MonstaWyatt/networking_project/images/breadboard_esp32_pirsensor.jpg

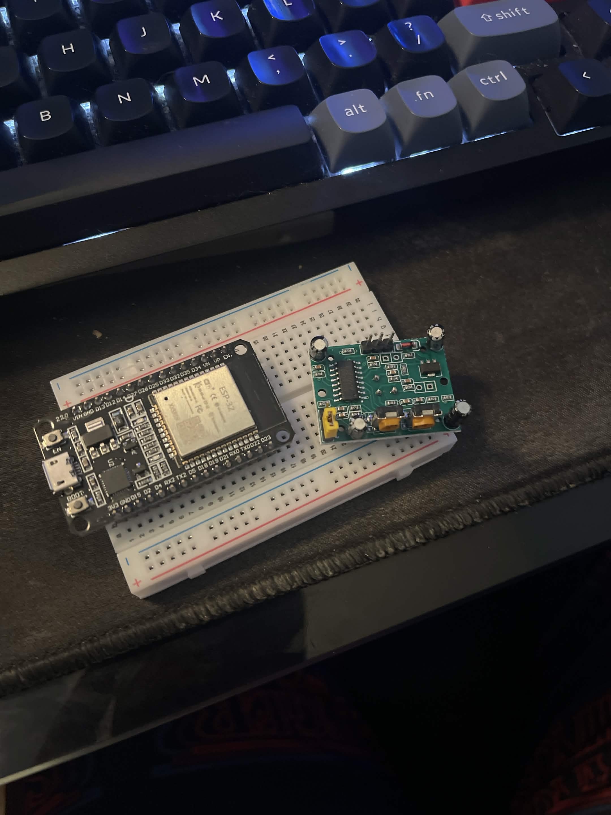
images/breadboard_esp32_pirsensor.jpg
