MonstaWyatt/networking_project/images/trying_to_use_a_breadboard.jpg

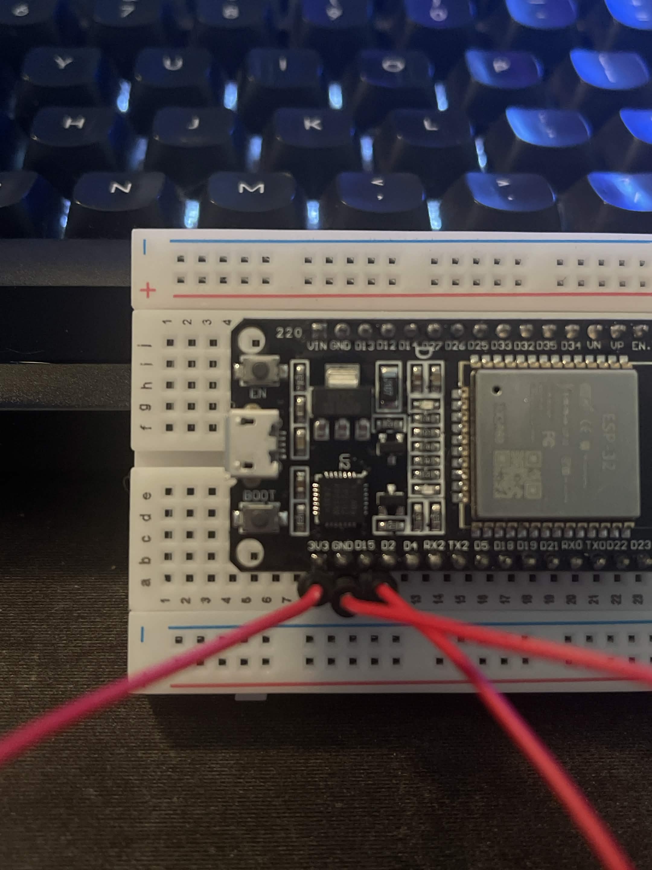
images/trying_to_use_a_breadboard.jpg
