MonstaWyatt/networking_project/images/project_hierarchy.png

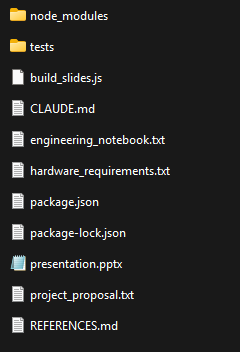
images/project_hierarchy.png
