MonstaWyatt/networking_project/images/serial_monitor.png

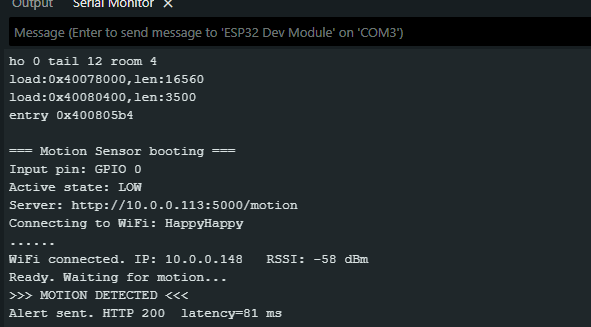
images/serial_monitor.png
