MonstaWyatt/networking_project/images/early_test.png

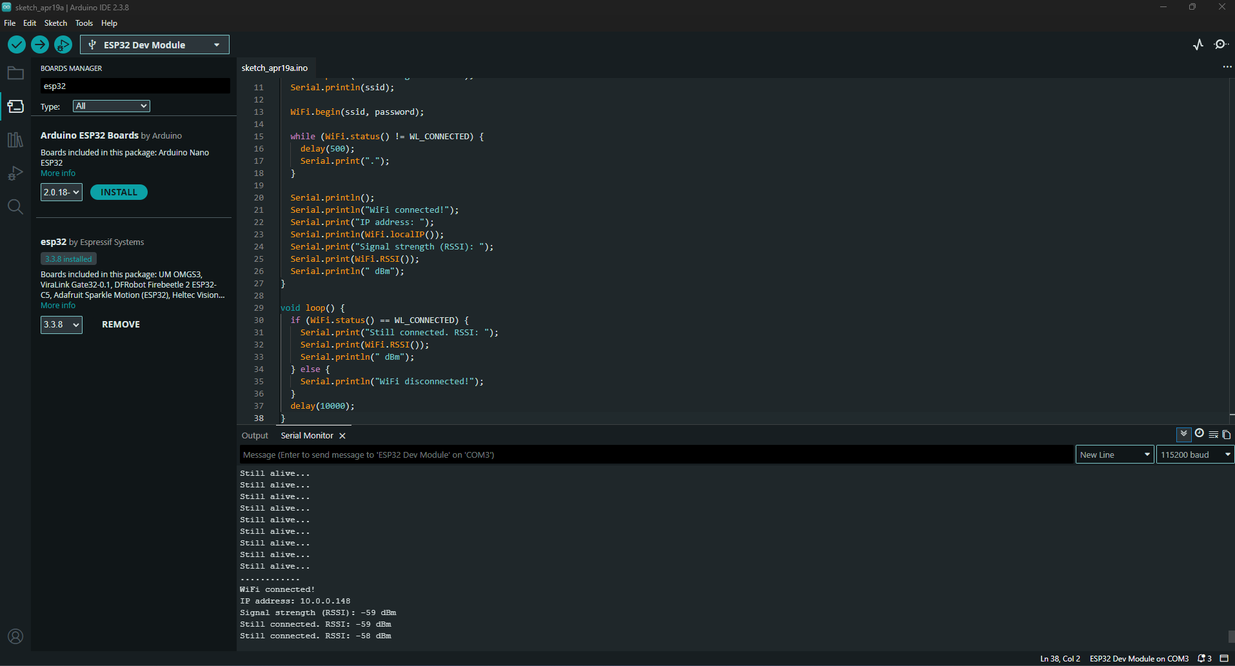
images/early_test.png
